TomOdw/Esp32FingerprintScanner/hardware/doorbell/frontplate/bohrschablone.pdf

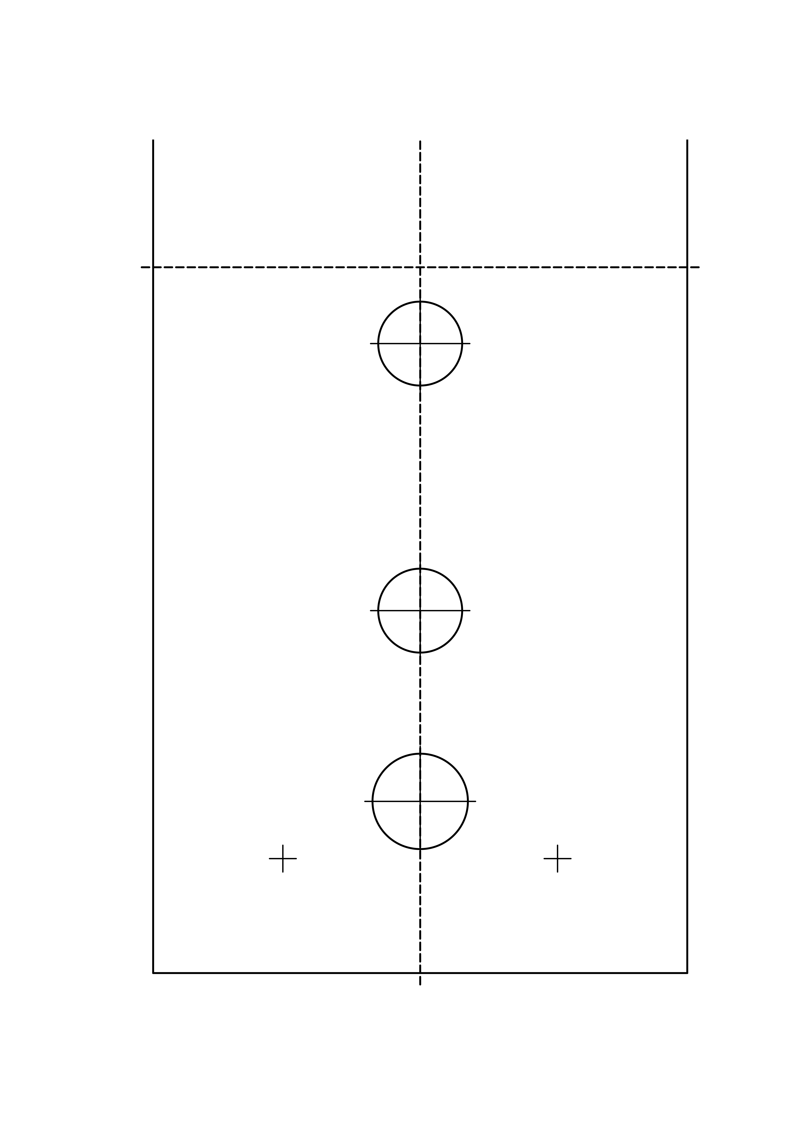
[picture p1: page 1]
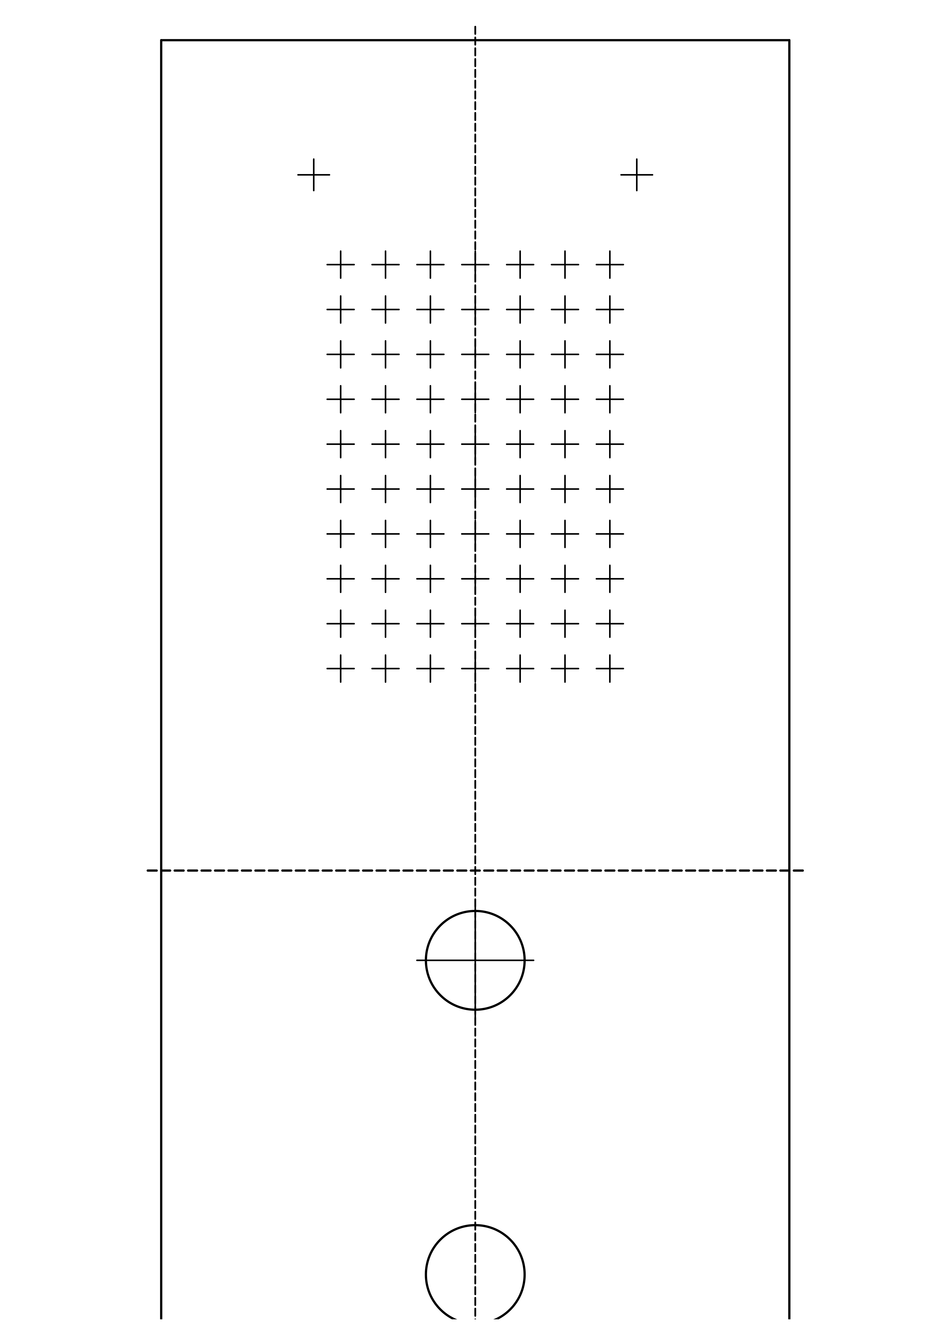
[picture p2: page 2]
