TomOdw/Esp32FingerprintScanner/hardware/doorbell/frontplate/klingel.FCStd

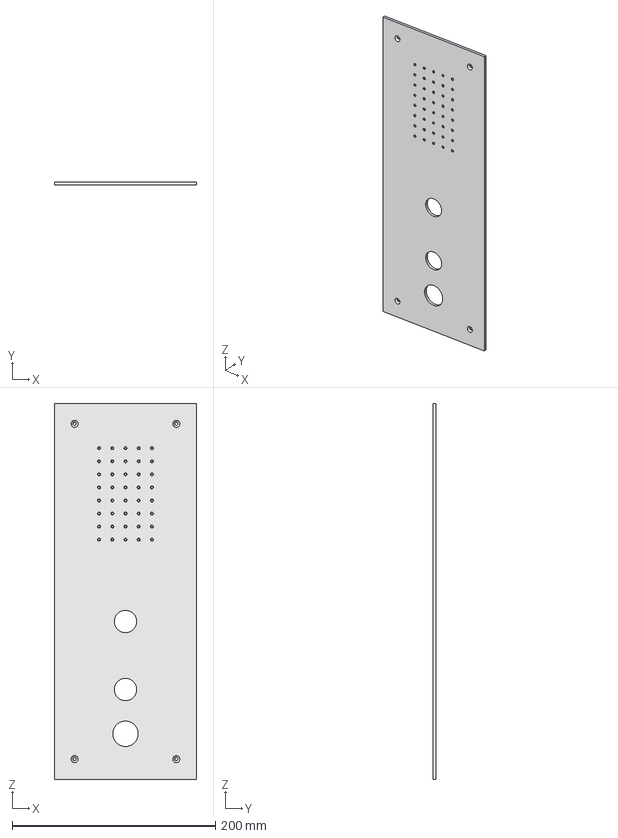
[picture p3: CAD file, 2026-06-07]
hardware/doorbell/frontplate/klingel.FCStd
140.0 x 3.00 x 370.0 mm
