TomOdw/Esp32FingerprintScanner/src/app_handles.h

/**
 * @file       app_handles.h
 * @brief      Global FreeRTOS handles and system event bit definitions
 *
 *             Declared here, defined in app.c. All modules that need to
 *             interact with shared inter-task primitives include this header.
 *
 * @author     Tom Christ
 * @copyright  Copyright (c) 2026 Tom Christ; MIT License
 * @date       2026-06-07
 *
 * @version    0.1  Initial Version
 */
#ifndef APP_HANDLES_H_
#define APP_HANDLES_H_

/******************************************************************************/
/*** Include files                                                            */
/******************************************************************************/
#include "freertos/FreeRTOS.h"
#include "freertos/semphr.h"
#include "freertos/queue.h"
#include "freertos/event_groups.h"

/******************************************************************************/
/*** System event bits                                                        */
/******************************************************************************/

/** WiFi STA connected and IP address obtained */
#define EVT_WIFI_CONNECTED  ((EventBits_t)(1U << 0))

/** Device running in WiFi AP mode */
#define EVT_WIFI_AP_MODE    ((EventBits_t)(1U << 1))

/** MQTT broker connection established */
#define EVT_MQTT_CONNECTED  ((EventBits_t)(1U << 2))

/** Fatal error signalled; reboot imminent */
#define EVT_CEH_FATAL       ((EventBits_t)(1U << 3))

/** A client device has been assigned an IP by the ESP32's own AP (Setup-Mode
 *  DIAG LED confirmation — see SWS-MOD109) */
#define EVT_WIFI_AP_CLIENT_CONNECTED ((EventBits_t)(1U << 4))

/******************************************************************************/
/*** Shared FreeRTOS handles                                                  */
/******************************************************************************/

/**
 * @brief Binary semaphore guarding exclusive FPM sensor access.
 *
 * Held during an active scan or enrollment sequence. The scanner task
 * acquires it only after the finger-sense GPIO interrupt fires.
 */
extern SemaphoreHandle_t g_fpm_mutex;

/**
 * @brief Binary semaphore given by the FP-sense GPIO ISR.
 *
 * The scanner task blocks on this semaphore while waiting for a finger.
 * Created and owned by io_init().
 */
extern SemaphoreHandle_t g_fp_sense_sem;

/**
 * @brief Queue of scan results from fps_ScanTask to mqtt_Task.
 *
 * Item type: mqtt_scan_event_t. Depth: 4.
 */
extern QueueHandle_t g_scan_queue;

/**
 * @brief System state event group (EVT_* bits above).
 */
extern EventGroupHandle_t g_sys_events;

#endif /* APP_HANDLES_H_ */
