TomOdw/Esp32FingerprintScanner/(commit log)

2026-06-07 Basic esp-idf project
    [klingel.FCStd]
2026-06-07 Added FingerPrintModule as a subrepo and an idf-component
2026-06-28 Sensor communication working
2026-07-26 Sens-pin of sensor no directly connected to GPIO26 again (without transistor)
